Pronoe/Pool-filtering-pump-manager/docs/pictures/2_test_config_20211218_230801.jpg

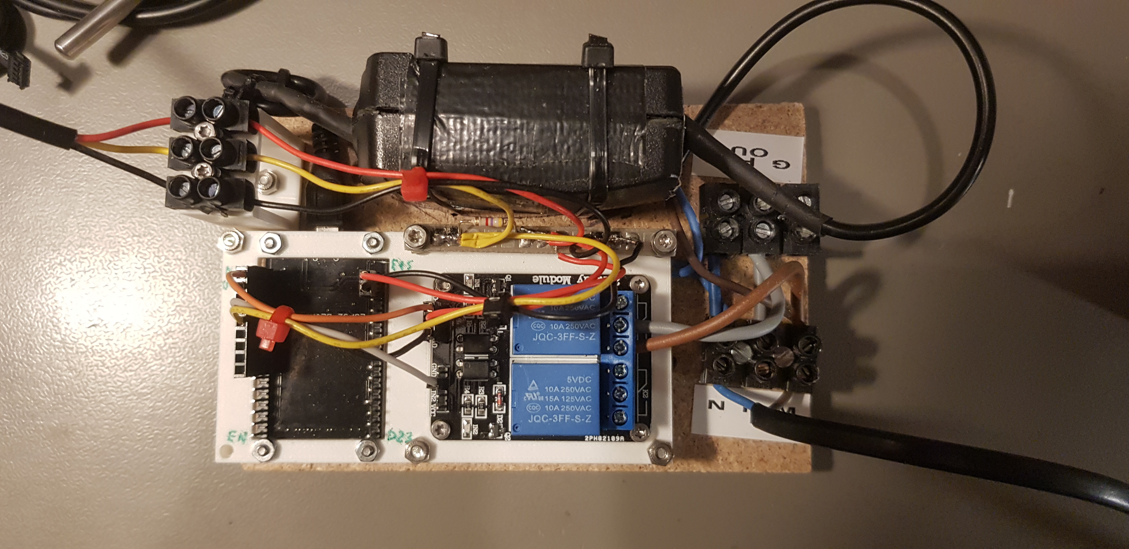
docs/pictures/2_test_config_20211218_230801.jpg
