Pronoe/Pool-filtering-pump-manager/docs/pictures/3_final_test_config_20220329_164553.jpg

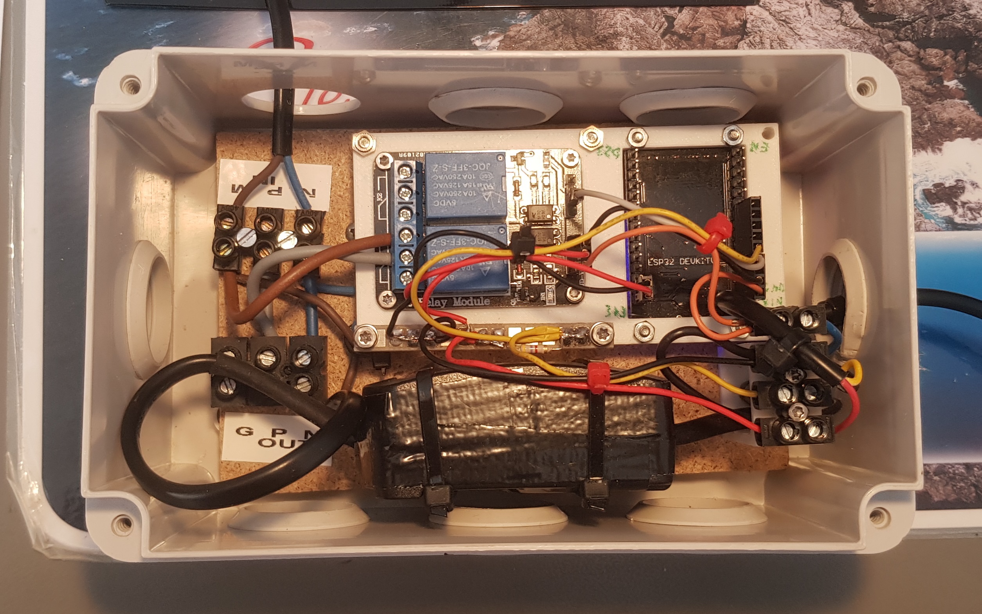
docs/pictures/3_final_test_config_20220329_164553.jpg
