Pronoe/Pool-filtering-pump-manager/docs/electric definition/schematic.pdf

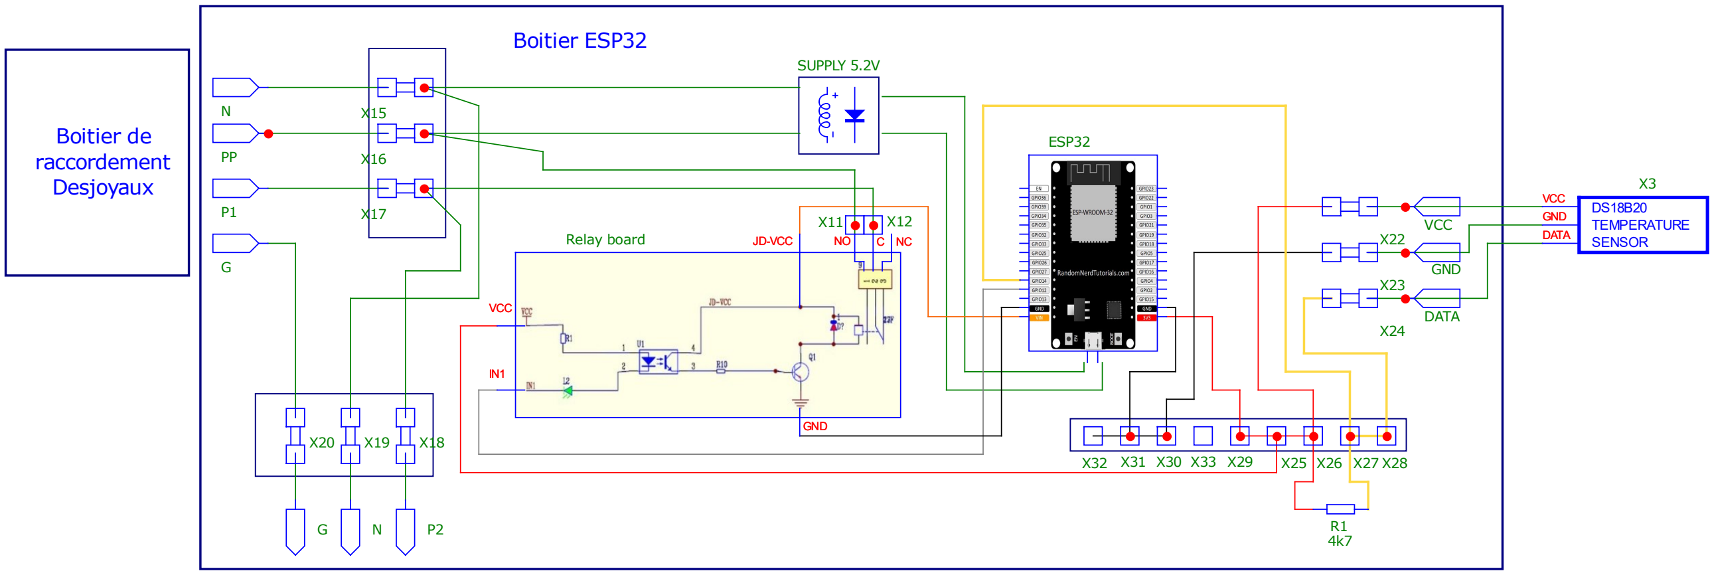
[picture p7: figure]
VCC; GND; JD-VCC; VCC GND DATA; ESP32; SUPPLY 5.2V; Relay board; DS18B20 TEMPERATURE SENSOR; DATA; Boitier de raccordement Desjoyaux; Boitier ESP32

X21

## Vers Pompe

## domino
