Pronoe/Pool-filtering-pump-manager/docs/BoostarpperStartup.jpg

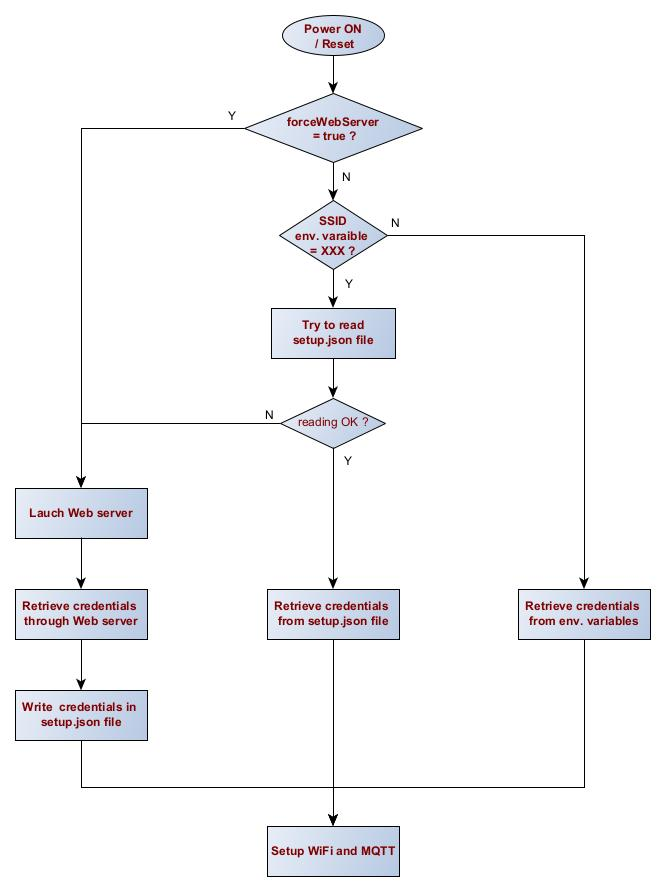
docs/BoostarpperStartup.jpg
