Pronoe/Pool-filtering-pump-manager/docs/pictures/4_pump_cabinet_integration__20220329_174501.jpg

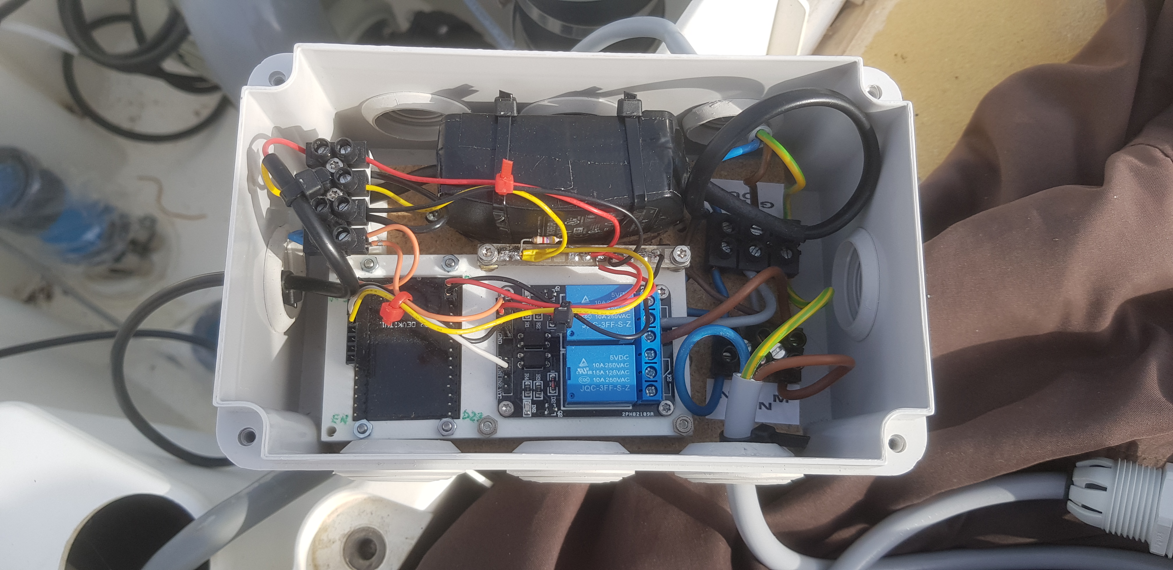
docs/pictures/4_pump_cabinet_integration__20220329_174501.jpg
