Pronoe/Pool-filtering-pump-manager/docs/pictures/5_pump_cabinet_integration_20220329_180736.jpg

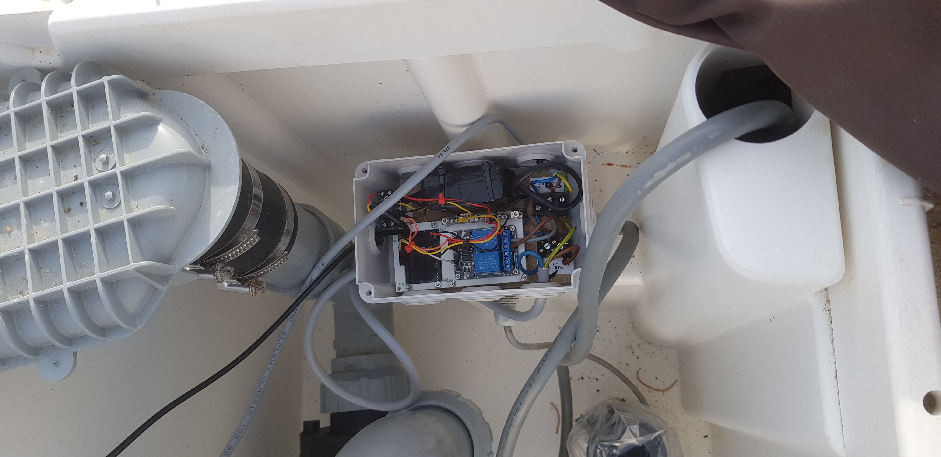
docs/pictures/5_pump_cabinet_integration_20220329_180736.jpg
