Pronoe/Pool-filtering-pump-manager/docs/pictures/6_pump_cabinet_integration_20220329_185100.jpg

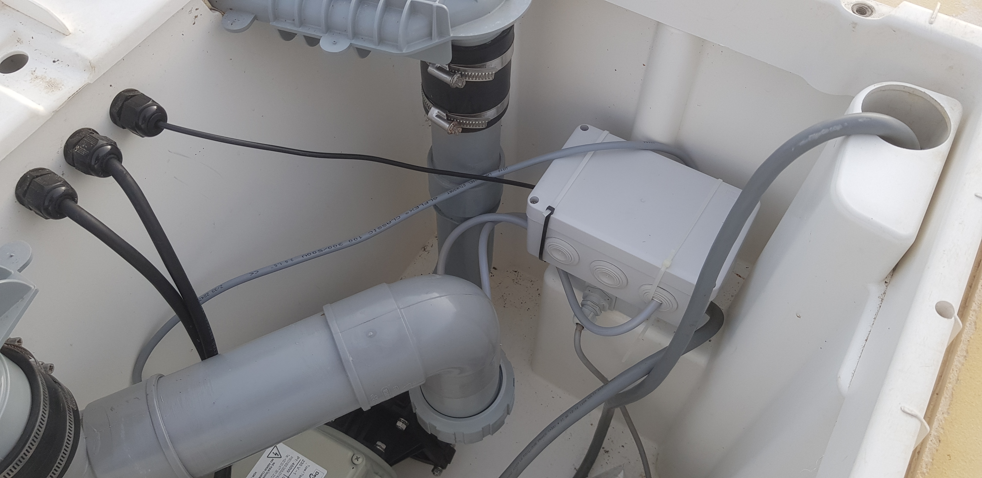
docs/pictures/6_pump_cabinet_integration_20220329_185100.jpg
