Pronoe/Pool-filtering-pump-manager/docs/pictures/8_Dashboard_HASS_pool.jpg

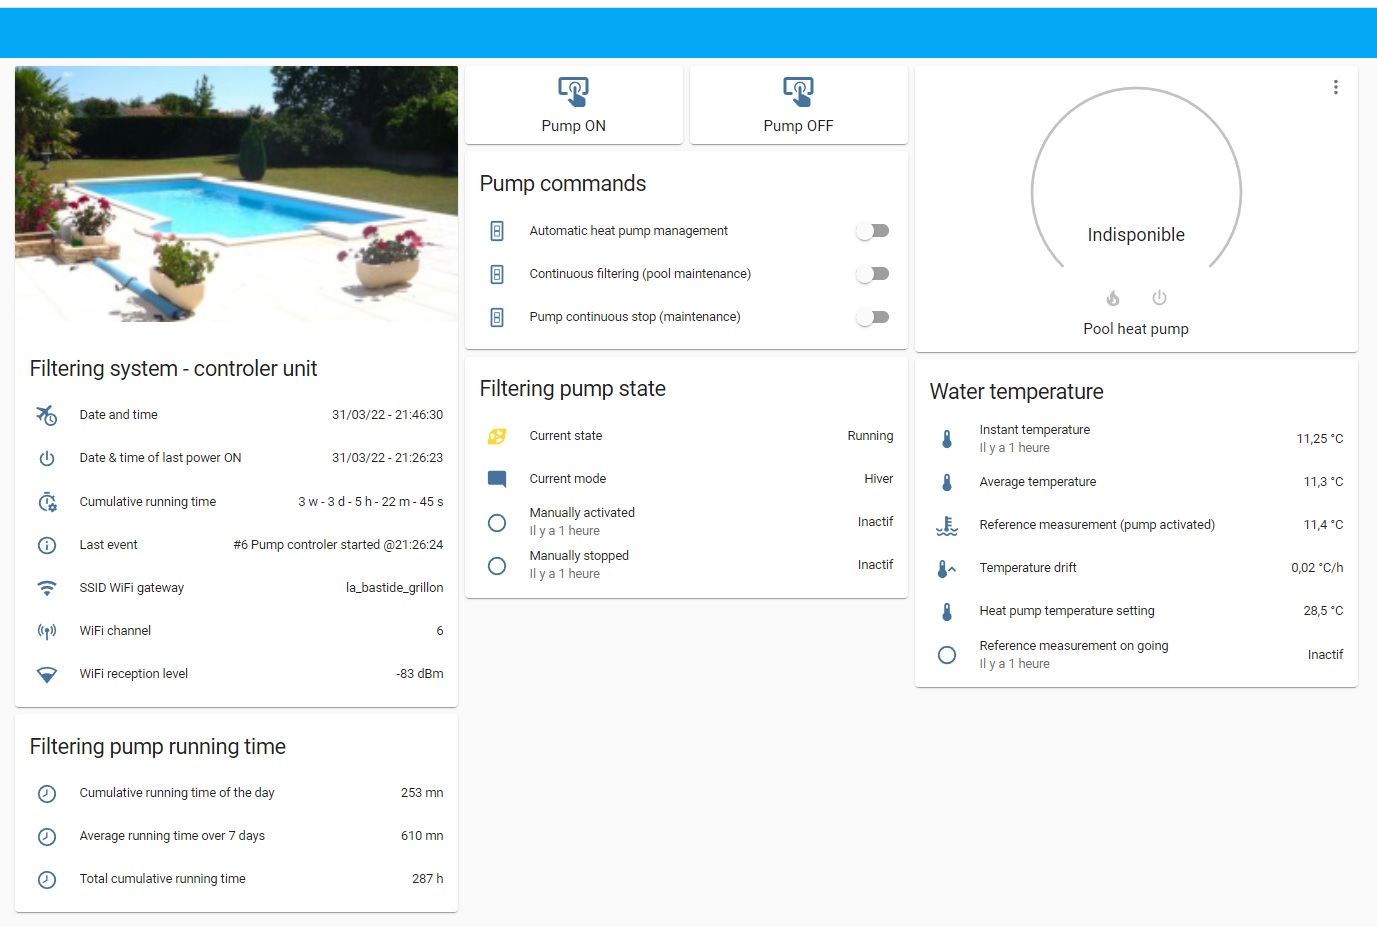
docs/pictures/8_Dashboard_HASS_pool.jpg
