Pronoe/Pool-filtering-pump-manager/docs/pictures/10_HASS_daily_pump_running_time.jpg

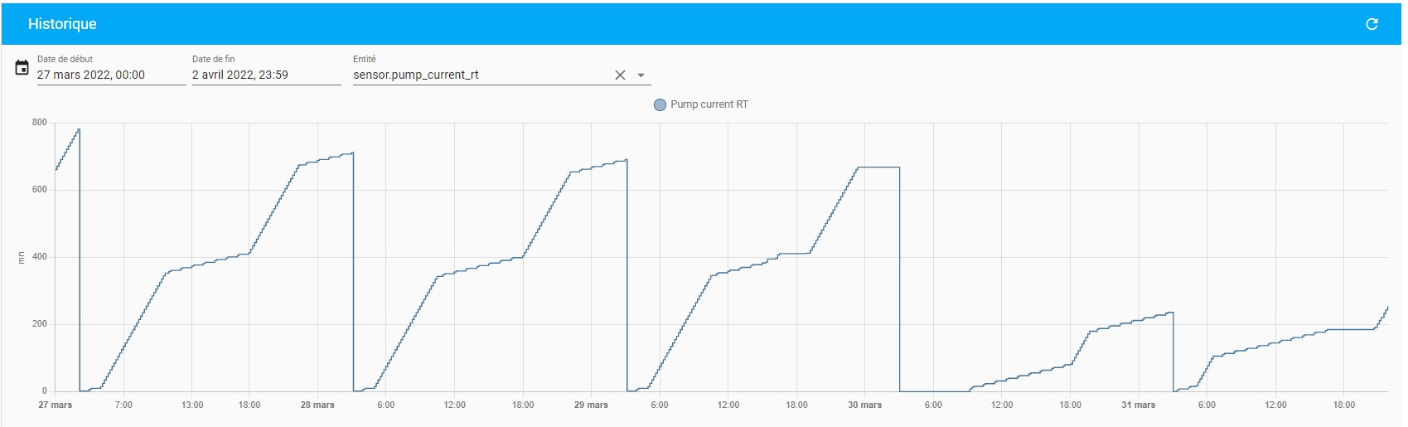
docs/pictures/10_HASS_daily_pump_running_time.jpg
