Pronoe/Pool-filtering-pump-manager/docs/pictures/11_HASS_pool_water_temp.jpg

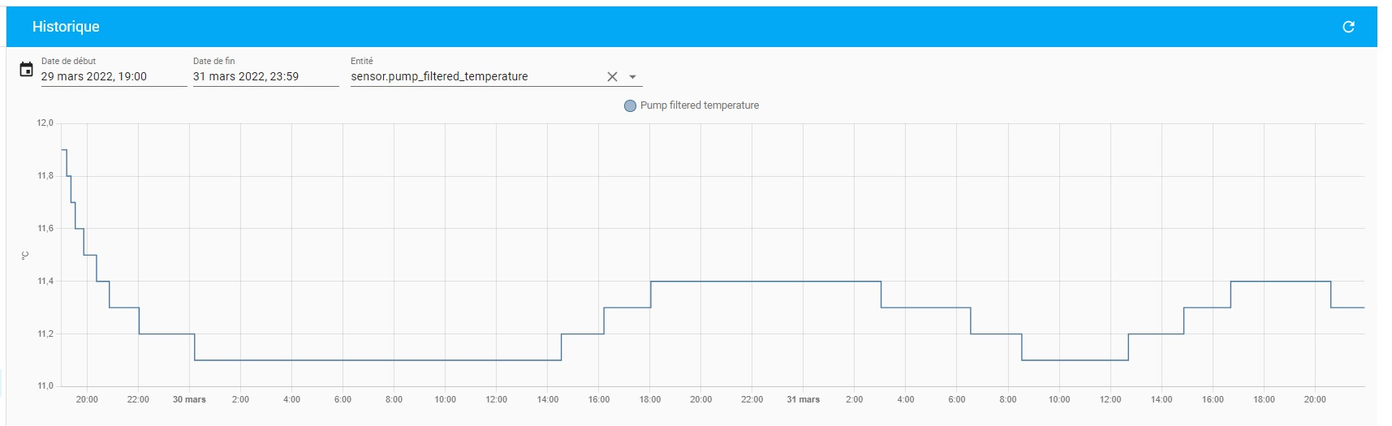
docs/pictures/11_HASS_pool_water_temp.jpg
