Pronoe/Pool-filtering-pump-manager/docs/pictures/12_p1.jpg

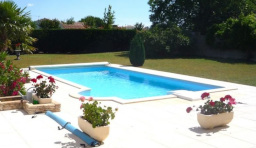
docs/pictures/12_p1.jpg
