Pronoe/Pool-filtering-pump-manager/docs/electric definition/Pin_out_ESP32_WROOM.xlsx

Sheet: Pin out WROOM
Name | No. | Type | Function | GPIO
GND | 1 | P | Ground
3V3 | 2 | P | Power supply
EN | 3 | I | Module-enable signal. Active high.
SENSOR_VP | 4 | I | GPIO36, ADC1_CH0, RTC_GPIO0 | GPIO36
SENSOR_VN | 5 | I | GPIO39, ADC1_CH3, RTC_GPIO3 | GPIO39
IO34 | 6 | I | GPIO34, ADC1_CH6, RTC_GPIO4 | GPIO34
IO35 | 7 | I | GPIO35, ADC1_CH7, RTC_GPIO5 | GPIO35
IO32 | 8 | I/O | GPIO32, XTAL_32K_P (32.768 kHz crystal oscillator input), ADC1_CH4, TOUCH9, RTC_GPIO9 | GPIO32
IO33 | 9 | I/O | GPIO33, XTAL_32K_N (32.768 kHz crystal oscillator output), ADC1_CH5, TOUCH8, RTC_GPIO8 | GPIO33
IO25 | 10 | I/O | GPIO25, DAC_1, ADC2_CH8, RTC_GPIO6, EMAC_RXD0 | GPIO25
IO26 | 11 | I/O | GPIO26, DAC_2, ADC2_CH9, RTC_GPIO7, EMAC_RXD1 | GPIO26
IO27 | 12 | I/O | GPIO27, ADC2_CH7, TOUCH7, RTC_GPIO17, EMAC_RX_DV | GPIO27
IO14 | 13 | I/O | GPIO14, ADC2_CH6, TOUCH6, RTC_GPIO16, MTMS, HSPICLK, HS2_CLK, SD_CLK, EMAC_TXD2 | GPIO14
IO12 | 14 | I/O | GPIO12, ADC2_CH5, TOUCH5, RTC_GPIO15, MTDI, HSPIQ, HS2_DATA2, SD_DATA2, EMAC_TXD3 | GPIO12
GND | 15 | P | Ground
IO13 | 16 | I/O | GPIO13, ADC2_CH4, TOUCH4, RTC_GPIO14, MTCK, HSPID, HS2_DATA3, SD_DATA3, EMAC_RX_ER | GPIO13
SHD/SD2* | 17 | I/O | GPIO9, SD_DATA2, SPIHD, HS1_DATA2, U1RXD | GPIO9
SWP/SD3* | 18 | I/O | GPIO10, SD_DATA3, SPIWP, HS1_DATA3, U1TXD | GPIO10
SCS/CMD* | 19 | I/O | GPIO11, SD_CMD, SPICS0, HS1_CMD, U1RTS | GPIO11
SCK/CLK* | 20 | I/O | GPIO6, SD_CLK, SPICLK, HS1_CLK, U1CTS | GPIO6
SDO/SD0* | 21 | I/O | GPIO7, SD_DATA0, SPIQ, HS1_DATA0, U2RTS | GPIO7
SDI/SD1* | 22 | I/O | GPIO8, SD_DATA1, SPID, HS1_DATA1, U2CTS | GPIO8
IO15 | 23 | I/O | GPIO15, ADC2_CH3, TOUCH3, MTDO, HSPICS0, RTC_GPIO13, HS2_CMD, SD_CMD, EMAC_RXD3 | GPIO15
IO2 | 24 | I/O | GPIO2, ADC2_CH2, TOUCH2, RTC_GPIO12, HSPIWP, HS2_DATA0, SD_DATA0 | GPIO2
IO0 | 25 | I/O | GPIO0, ADC2_CH1, TOUCH1, RTC_GPIO11, CLK_OUT1, EMAC_TX_CLK | GPIO0
IO4 | 26 | I/O | GPIO4, ADC2_CH0, TOUCH0, RTC_GPIO10, HSPIHD, HS2_DATA1, SD_DATA1, EMAC_TX_ER | GPIO4
IO16 | 27 | I/O | GPIO16, HS1_DATA4, U2RXD, EMAC_CLK_OUT | GPIO16
IO17 | 28 | I/O | GPIO17, HS1_DATA5, U2TXD, EMAC_CLK_OUT_180 | GPIO17
IO5 | 29 | I/O | GPIO5, VSPICS0, HS1_DATA6, EMAC_RX_CLK | GPIO5
IO18 | 30 | I/O | GPIO18, VSPICLK, HS1_DATA7 | GPIO18
IO19 | 31 | I/O | GPIO19, VSPIQ, U0CTS, EMAC_TXD0 | GPIO19
NC | 32 | - | -
IO21 | 33 | I/O | GPIO21, VSPIHD, EMAC_TX_EN | GPIO21
RXD0 | 34 | I/O | GPIO3, U0RXD, CLK_OUT2 | GPIO3
TXD0 | 35 | I/O | GPIO1, U0TXD, CLK_OUT3, EMAC_RXD2 | GPIO1
IO22 | 36 | I/O | GPIO22, VSPIWP, U0RTS, EMAC_TXD1 | GPIO22
IO23 | 37 | I/O | GPIO23, VSPID, HS1_STROBE | GPIO23
GND | 38 | P | Ground | Ground

Sheet: Pin out module
PIN # | Name | Name WROOM32 | Description | GPIO | Input | Output | Notes | ADC | TXD | RXD | SPI | TOUCH
1 | 3V3 | 3V3 | Power supply
2 | GND | GND | Ground
3 | D15 | IO15 | GPIO15, ADC2_CH3, TOUCH3, MTDO, HSPICS0, RTC_GPIO13, HS2_CMD, SD_CMD, EMAC_RXD3 | 15 | OK | OK | outputs PWM signal at boot | X |  | X | X | X
4 | D2 | IO2 | GPIO2, ADC2_CH2, TOUCH2, RTC_GPIO12, HSPIWP, HS2_DATA0, SD_DATA0 | 2 | OK | OK | connected to on-board LED | X |  |  | X | X
5 | D4 | IO4 | GPIO4, ADC2_CH0, TOUCH0, RTC_GPIO10, HSPIHD, HS2_DATA1, SD_DATA1, EMAC_TX_ER | 4 | OK | OK |  | X |  |  | X | X
6 | RX2 | IO16 | GPIO16, HS1_DATA4, U2RXD, EMAC_CLK_OUT | 16 | OK | OK |  |  |  | X
7 | TX2 | IO17 | GPIO17, HS1_DATA5, U2TXD, EMAC_CLK_OUT_180 | 17 | OK | OK |  |  | X
8 | D5 | IO5 | GPIO5, VSPICS0, HS1_DATA6, EMAC_RX_CLK | 5 | OK | OK | outputs PWM signal at boot - 10k in serial |  |  |  | X
9 | D18 | IO18 | GPIO18, VSPICLK, HS1_DATA7 | 18 | OK | OK |  |  |  |  | X
10 | D19 | IO19 | GPIO19, VSPIQ, U0CTS, EMAC_TXD0 | 19 | OK | OK |  |  | X |  | X
11 | D21 | IO21 | GPIO21, VSPIHD, EMAC_TX_EN | 21 | OK | OK |  |  |  |  | X
12 | RX0 | RXD0 | GPIO3, U0RXD, CLK_OUT2 | 3 | RX pin | RX | pin HIGH at boot - used for USB downloading |  |  | X
13 | TX0 | TXD0 | GPIO1, U0TXD, CLK_OUT3, EMAC_RXD2 | 1 | TX pin | OK | debug output at boot - 10k in serial |  | X | X
14 | D22 | IO22 | GPIO22, VSPIWP, U0RTS, EMAC_TXD1 | 22 | OK | OK |  |  | X |  | X
15 | D23 | IO23 | GPIO23, VSPID, HS1_STROBE | 23 | OK | OK |  |  |  |  | X
16 | EN | EN | Module-enable signal. Active high.
17 | VP | SENSOR_VP | GPIO36, ADC1_CH0, RTC_GPIO0 | 36 | OK | x | input only with no pullup | X
18 | VN | SENSOR_VN | GPIO39, ADC1_CH3, RTC_GPIO3 | 39 | OK | x | input only with no pullup | X
19 | D34 | IO34 | GPIO34, ADC1_CH6, RTC_GPIO4 | 34 | OK | x | input only with no pullup | X
20 | D35 | IO35 | GPIO35, ADC1_CH7, RTC_GPIO5 | 35 | OK | x | input only with no pullup | X
21 | D32 | IO32 | GPIO32, XTAL_32K_P (32.768 kHz crystal oscillator input), ADC1_CH4, TOUCH9, RTC_GPIO9 | 32 | OK | OK |  | X |  |  |  | X
22 | D33 | IO33 | GPIO33, XTAL_32K_N (32.768 kHz crystal oscillator output), ADC1_CH5, TOUCH8, RTC_GPIO8 | 33 | OK | OK |  | X |  |  |  | X
23 | D25 | IO25 | GPIO25, DAC_1, ADC2_CH8, RTC_GPIO6, EMAC_RXD0 | 25 | OK | OK |  | X |  | X
24 | D26 | IO26 | GPIO26, DAC_2, ADC2_CH9, RTC_GPIO7, EMAC_RXD1 | 26 | OK | OK |  | X |  | X
25 | D27 | IO27 | GPIO27, ADC2_CH7, TOUCH7, RTC_GPIO17, EMAC_RX_DV | 27 | OK | OK |  | X |  |  |  | X
26 | D14 | IO14 | GPIO14, ADC2_CH6, TOUCH6, RTC_GPIO16, MTMS, HSPICLK, HS2_CLK, SD_CLK, EMAC_TXD2 | 14 | OK | OK | outputs PWM signal at boot | X | X |  | X | X
27 | D12 | IO12 | GPIO12, ADC2_CH5, TOUCH5, RTC_GPIO15, MTDI, HSPIQ, HS2_DATA2, SD_DATA2, EMAC_TXD3 | 12 | OK | OK | boot fail if pulled high | X | X |  | X | X
28 | D13 | IO13 | GPIO13, ADC2_CH4, TOUCH4, RTC_GPIO14, MTCK, HSPID, HS2_DATA3, SD_DATA3, EMAC_RX_ER | 13 | OK | OK |  | X |  |  | X | X
29 | GND | GND | Ground
30 | VIN | N/A | Supply voltage - 7 to 12V
 |  |  | Note: ADC on pin D4, D12, D13, D14, D15, D25, D26, D27 can be read only with WiFi not started (ADC2 channels)
 |  |  | max output current per GPIO: 40 mA

Sheet: Utilisation
GPIO | Input | Output | Notes
0 | pulled up | OK | outputs PWM signal at boot
1 | TX pin | OK | debug output at boot - 10k in serial
2 | OK | OK | connected to on-board LED
3 | RX pin | RX | pin HIGH at boot - used for USB downloading
4 | OK | OK
5 | OK | OK | outputs PWM signal at boot - 10k in serial
6 | x | x | connected to the integrated SPI flash
7 | x | x | connected to the integrated SPI flash
8 | x | x | connected to the integrated SPI flash
9 | x | x | connected to the integrated SPI flash
10 | x | x | connected to the integrated SPI flash
11 | x | x | connected to the integrated SPI flash
12 | OK | OK | boot fail if pulled high
13 | OK | OK
14 | OK | OK | outputs PWM signal at boot
15 | OK | OK | outputs PWM signal at boot
16 | OK | OK
17 | OK | OK
18 | OK | OK
19 | OK | OK
21 | OK | OK
22 | OK | OK
23 | OK | OK
25 | OK | OK
26 | OK | OK
27 | OK | OK
32 | OK | OK
33 | OK | OK
34 | OK | x | input only with no pullup
35 | OK | x | input only with no pullup
36 | OK | x | input only with no pullup
39 | OK | x | input only with no pullup
