Pronoe/Pool-filtering-pump-manager/docs/mechanical parts/assemblage_circuits_V1.FCStd

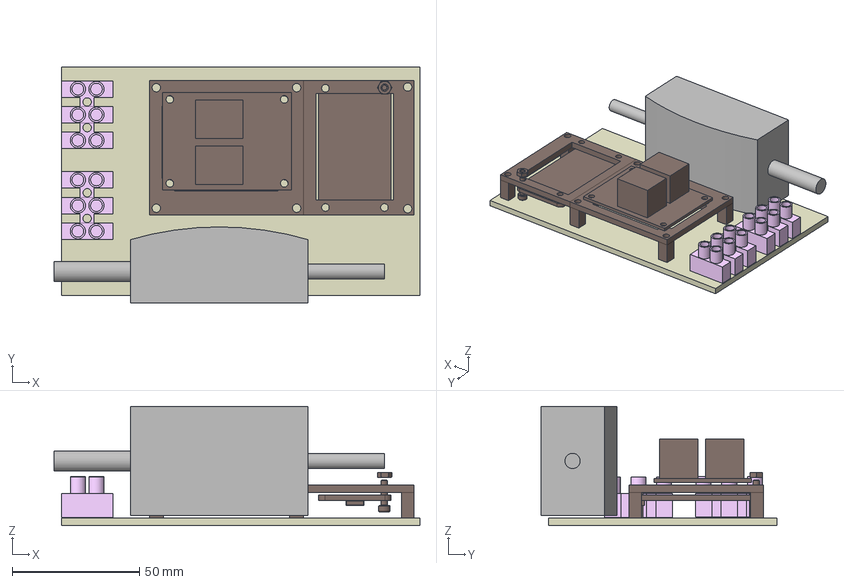
[picture p16: CAD file, 2022-01-09]
docs/mechanical parts/assemblage_circuits_V1.FCStd
144.0 x 93.0 x 47.0 mm
Alim
plaque_support
ensemble_electronique
Domino3
Domino3_pompe
