Pronoe/Pool-filtering-pump-manager/docs/mechanical parts/support_domino.FCStd

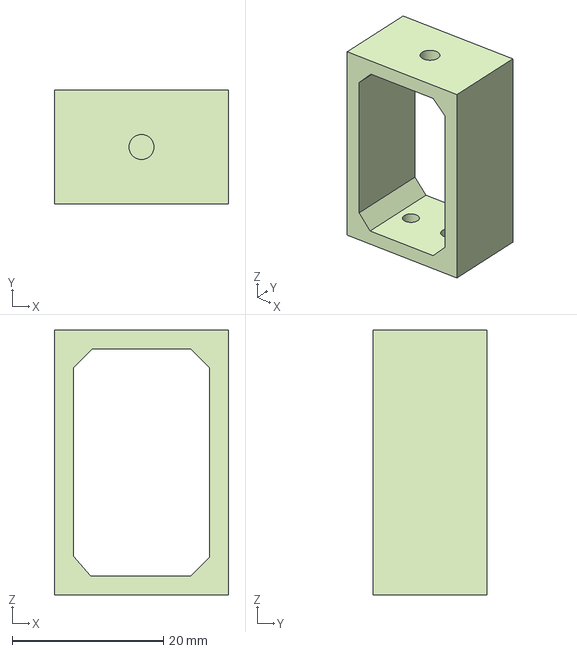
[picture p17: CAD file, 2022-01-09]
docs/mechanical parts/support_domino.FCStd
23.0 x 15.0 x 35.0 mm
