Pronoe/Pool-filtering-pump-manager/docs/mechanical parts/support_V1.stl

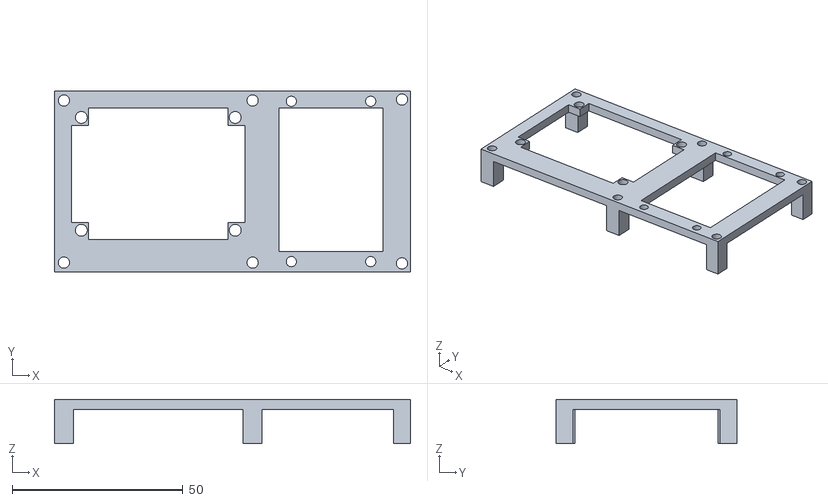
[picture p18: CAD file, 2022-01-09]
docs/mechanical parts/support_V1.stl
104.1 x 52.9 x 13.0
