Pronoe/Pool-filtering-pump-manager/(list of files, cad)

Other CAD files:
docs/mechanical parts/support_domino.stl
