Pronoe/Pool-filtering-pump-manager/docs/pictures/7_temperature_probe_install_20220329_185122.jpg

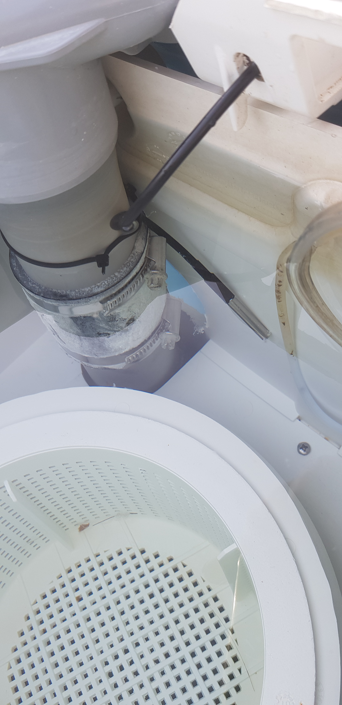
docs/pictures/7_temperature_probe_install_20220329_185122.jpg
