Pronoe/Pool-filtering-pump-manager/docs/BoostarpperStartup.pdf

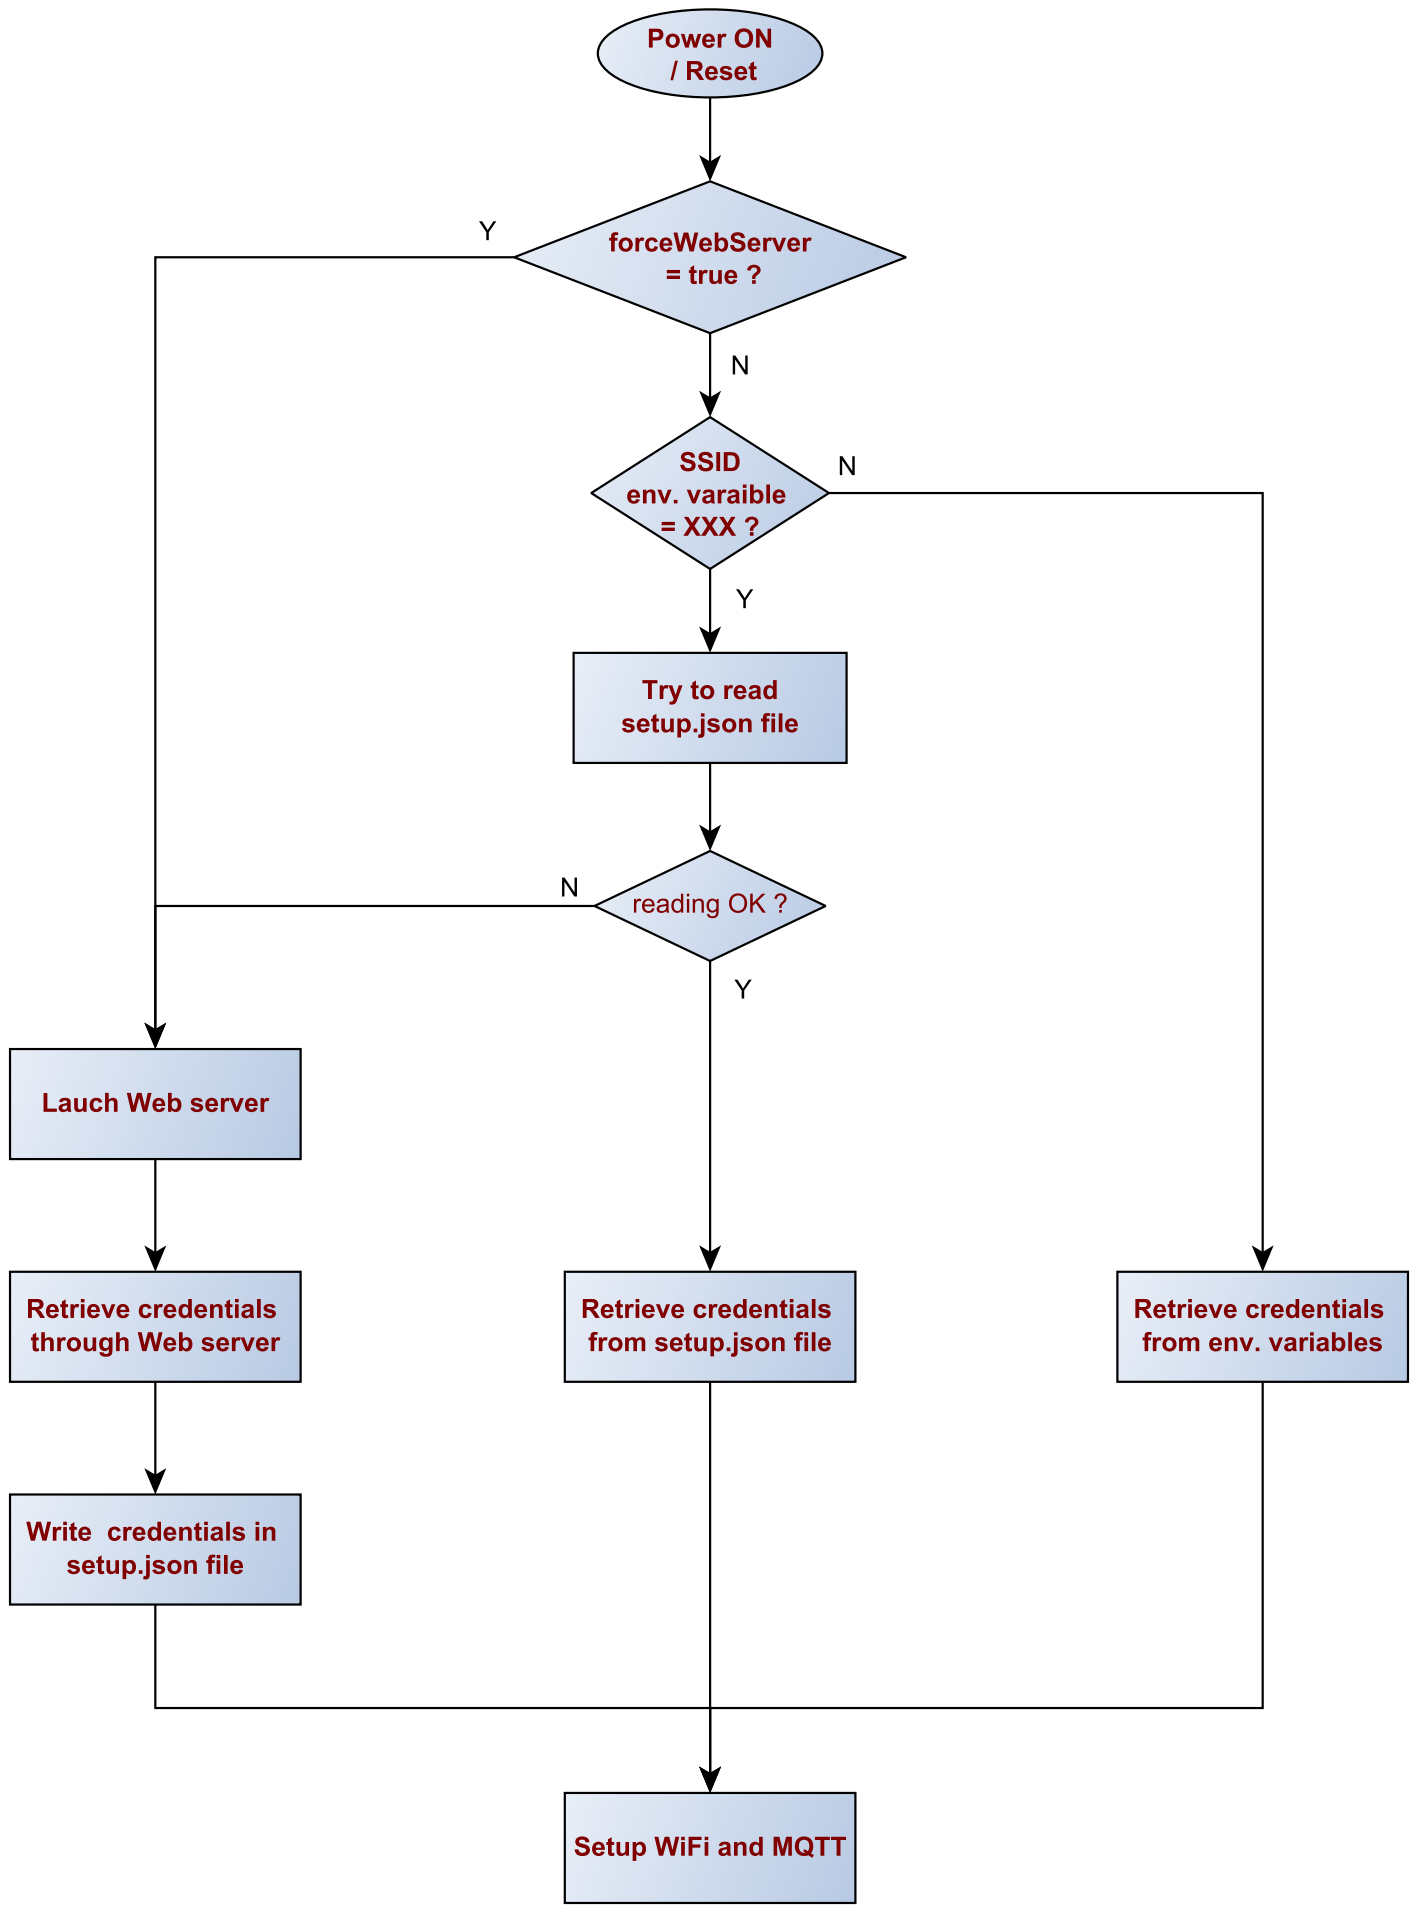
[picture p20: page 1]
