Pronoe/Pool-filtering-pump-manager/(commit log)

2022-01-09 add docs folder with technical files
    [Pin_out_ESP32_WROOM.xlsx, assemblage_circuits_V1.FCStd, support_V1.stl, support_domino.FCStd, support_domino.stl]
2022-01-09 add pump controler schematic under MicroCap 12 file format
